pekpuglia/IC-Thrust-Vector-Control/README.md

# IC-Thrust-Vector-Control
Iniciação científica sobre vetoração de empuxo
