pekpuglia/IC-Thrust-Vector-Control/report/PreTextuais/listasimbolos.tex

\begin{longtable}{ll}
\(F\) & Empuxo propulsivo \\
\(\dot{m}\) & Vazão mássica \\
\(v_e\) & Velocidade de exaustão média \\
\(p_c\) & Pressão de câmara \\
\(p_e\) & Pressão de saída média \\
\(p_{amb}\) & Pressão ambiente \\
\(A_c\) & Área da seção transversal da câmara \\
\(A_e\) & Área da seção transversal da saída da tubeira \\
\(A_t\) & Área da seção transversal da garganta \\
\(\varepsilon \) & Razão de expansão \\
\(I_{\mathrm{sp}}\) & Impulso específico \\
\(C_F\) & Coeficiente de empuxo \\
\(C^*\) & Velocidade característica \\
\(F_x\) & Força horizontal, transversal ao motor foguete \\
\(F_y\) & Força vertical, na direção do empuxo propulsivo \\
\(M\) & Torque resultante \\
\(\delta \) & Deflexão da lâmina (\textit{jet vane}) \\
\(F_{x\delta}\) & Derivada da força lateral em relação à deflexão da lâmina \\
\(M_\delta \) & Derivada de momento em relação à deflexão da lâmina
\end{longtable}
