pekpuglia/IC-Thrust-Vector-Control/report/tese.tex

%%% Exemplo de utilização da classe ITA
%%%
%%%   por        Fábio Fagundes Silveira   -  ffs [at] ita [dot] br
%%%              Benedito C. O. Maciel     -  bcmaciel [at] ita [dot] br
%%%              Giovani Volnei Meinertz   -  giovani [at] ita [dot] br
%%%    	         Hudson Alberto Bode       -  bode [at] ita [dot]br
%%%    	         P. I. Braga de Queiroz    -  pi [at] ita [dot] br
%%%    	         Jorge A. B. Gripp         -  gripp [at] ita [dot] br
%%%    	         Juliano Monte-Mor         -  jamontemor [at] yahoo [dot] com [dot] br
%%%    	         Tarcisio A. B. Gripp      -  tarcisio.gripp [at] gmail [dot] com
%%%
%%%   Versão para overleaf:
%%%   por        Alejandro A. Rios Cruz    - aarc.88@gmail.com
%%%              Saulo Gómez               - sagomezs@unal.edu.co
%%%              Ocimar Santos             - ocimar.acad@gmail.com
%%%
%%%   Template disponibilizado em:
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
%   								dsc      		= Tese de Doutorado
%   								dscfem   		= Para Doutoras
%   								quali    		= Exame de Qualificacao
%   								qualifem 		= Exame de Qualificacao para Doutoras
% Para 'Draft Version'/'Versao Preliminar' com data no rodape, adicionar 'dv':
%   \documentclass[dsc, dv]{ita}
% Para trabalhos em Inglês, adicionar 'eng':
%   \documentclass[dsc, eng]{ita}
%		\documentclass[dsc, eng, dv]{ita}
%++++++++++++++++++++++++++++++++++++++++++++++++++++++++++++++++++++++++++++++
\documentclass[tg]{ita}    % ITA.cls based on standard book.cls
% Quando alterar a classe, por exemplo de [msc] para [msc, eng]) rode mais uma vez o botão BUILD OUTPUT caso haja erro
\usepackage[utf8]{inputenc}
\usepackage{ae}
\usepackage{graphicx}
\usepackage{epsfig}
\usepackage{amsmath}
\usepackage{amssymb}
\usepackage{subcaption}
\usepackage{multirow}
\usepackage{float}
\usepackage{amsthm}
\usepackage{url}         % formats URL addresses properly
\usepackage{appendix}    % allows appendix section to be included
\usepackage{lscape}      % allows a page to be rendered in landscape mode
\usepackage{multicol}    % allows text in multi columns
\usepackage{cancel}      % needed to show canceled terms in equations
\usepackage{lettrine}
\usepackage{float}
\usepackage{placeins}

%HHHHHHHHHHHHHHHHHHHHHHHHHHHHHHHHHHHHHHHHHHHHHHHHHHHHHHHHHHHHHHHHHHHHHHHHHHHHHHHHHHHHHHHHHHHHHHHHHHHHHHHHHHHH
%\usepackage{subfigure}
%\usepackage{subfigmat}
%PACOTEFIGURAS_SE _ERRADO_ESXCLUIR_ACIMA
\usepackage{booktabs}
%PACOTETABELAS_SE _ERRADO_ESXCLUIR_ACIMA
%HHHHHHHHHHHHHHHHHHHHHHHHHHHHHHHHHHHHHHHHHHHHHHHHHHHHHHHHHHHHHHHHHHHHHHHHHHHHHHHHHHHHHHHHHHHHHHHHHHHHHHHHHHHH

%++++++++++++++++++++++++++++++++++++++++++++++++++++++++++++++++++++++++++++++
% Espaçamento padrão de todo o documento
%++++++++++++++++++++++++++++++++++++++++++++++++++++++++++++++++++++++++++++++
\onehalfspacing

%singlespacing Para um espaçamento simples
%onehalfspacing Para um espaçamento de 1,5
%doublespacing Para um espaçamento duplo

%++++++++++++++++++++++++++++++++++++++++++++++++++++++++++++++++++++++++++++++
% Identificacoes (se o trabalho for em inglês, insira os dados em inglês)
% Para entradas abreviadas de Professora (Profa.) em português escreva: Prof$^\textnormal{a}$.
%++++++++++++++++++++++++++++++++++++++++++++++++++++++++++++++++++++++++++++++
\course{Engenheria Aeroespacial}  % Programa de PG ou Curso de Graduação
%\area{Aircraft Design} % Área de concentração na PG (Não utilizado no caso de TG)

% Autor do trabalho: Nome Sobrenome
\authorgender{masc}                     %sexo: masc ou fem
\author{Pedro Kuntz}{Puglia}
\itaauthoraddress{Rua H8C, Ap. 303}{12.228- 462}{São José dos Campos- SP}

% Titulo da Tese/Dissertação
\title{Caracterização de sistema de propulsão a gás frio com vetorização de empuxo}

% Orientador
\advisorgender{masc}                    % masc ou fem
\advisor{Prof.~Dr.}{Leonardo Gouvêa}{ITA}

% Coorientador (Caso não haja coorientador, colocar ambas as variáveis \coadvisorgender e \coadvisor comentadas, com um % na frente)
\coadvisorgender{masc}									% masc ou fem
\coadvisor{Prof.~Dr.}{Maurício Morales}{ITA}

% Pró-reitor da Pós-graduação
% \bossgender{masc}												% masc ou fem
% \boss{Prof.~Dr.}{John von Neumann}

%Coordenador do curso no caso de TG
\bosscoursegender{fem}									% masc ou fem
\bosscourse{Profa.~Dra.}{Cristiane Martins}

% Palavras-Chaves informadas pela Biblioteca -> utilizada na CIP
\kwcip{Propulsão}
\kwcip{Gás Frio}
\kwcip{Vetorização de empuxo}

% membros da banca examinadora

% \examiner{Prof. Dr.}{Alan Turing}{Presidente}{ITA}
% \examiner{Prof. Dr.}{Linus Torwald}{}{UXXX}
% \examiner{Prof. Dr.}{Richard Stallman}{}{UYYY}
% \examiner{Prof. Dr.}{Donald Duck}{}{DYSNEY}
% \examiner{Prof. Dr.}{Mickey Mouse}{}{DISNEY}

% Data da defesa (mês em maiúsculo, se trabalho em inglês, e minúsculo se trabalho em português)
\date{11}{julho}{2023}

% Número CDU - (somente para TG)
\cdu{???.??}

% Glossario
\makeglossary
\frontmatter

\begin{document}
\input{PreTextuais/main}

\mainmatter

%todo
%resumo, abstract

% Os capitulos comecam aqui
\chapter{\textbf{INTRODUÇÃO}}
\input{text/intro.tex}

\chapter{\textbf{METODOLOGIA}}
\input{text/metodologia.tex}

\chapter{\textbf{RESULTADOS E DISCUSSÃO}}
\input{text/resultados.tex}

\chapter{\textbf{CONCLUSÃO}}
\input{text/conclusao.tex}
% REFERENCIAS BIBLIOGRAFICAS
\renewcommand\bibname{\itareferencesnamebabel} %renomear título do capítulo referências
\bibliography{Referencias/referencias}

% Apendices
\appendix
\chapter{Histórico de desenvolvimento do motor foguete}\label{sec:app}
\input{text/apendice.tex}

% Anexos
\annex

% Glossario
%\itaglossary
%\printglossary

% Folha de Registro do Documento
% Valores dos campos do formulario
\FRDitadata{25 de março de 2015}
\FRDitadocnro{DCTA/ITA/DM-018/2015} %(o número de registro você solicita a biblioteca)
\FRDitaorgaointerno{Instituto Tecnológico de Aeronáutica -- ITA}
%Exemplo no caso de pós-graduação: Instituto Tecnol{\'o}gico de Aeron{\'a}utica -- ITA
\FRDitapalavrasautor{Cupim; Cimento; Estruturas}
\FRDitapalavrasresult{Propulsão; Gás Frio; Vetorização de empuxo;}
%Exemplo no caso de graduação (TG):
%\FRDitapalavraapresentacao{Trabalho de Graduação, ITA, São José dos Campos, 2015. \NumPenultimaPagina\ páginas.}
%Exemplo no caso de pós-graduação (msc, dsc):
\FRDitapalavraapresentacao{ITA, São José dos Campos. Curso de Mestrado. Programa de Pós-Graduação em Engenharia Aeronáutica e Mecânica. Área de Sistemas Aeroespaciais e Mecatrônica. Orientador: Prof.~Dr. Adalberto Santos Dupont. Coorientadora: Prof$^\textnormal{a}$.~Dr$^\textnormal{a}$. Doralice Serra. Defesa em 05/03/2015. Publicada em 25/03/2015.}
\FRDitaresumo{\input{PreTextuais/resumo}}
%  Primeiro Parametro: Nacional ou Internacional -- N/I
%  Segundo parametro: Ostensivo, Reservado, Confidencial ou Secreto -- O/R/C/S
\FRDitaOpcoes{N}{O}
% Cria o formulario
\itaFRD

\end{document}
% Fim do Documento. O massacre acabou!!! :-)
