pekpuglia/IC-Thrust-Vector-Control/report/text/conclusao.tex

A proposta deste trabalho, de desenvolver um sistema de vetorização de empuxo e caracterizar seu desempenho, foi executada. Desenvolveu-se um motor foguete de gás frio de \(2\;\mathrm{N} \) que foi validado experimentalmente e então usado em um sistema de vetorização de empuxo com lâmina defletora (\textit{jet vane}). Por fim, este sistema foi caracterizado em relação à perda de empuxo causada pela adição da lâmina defletora e suas derivadas de controle foram obtidas. Apesar do objetivo ter sido atingido, foram encontradas várias dificuldades e fontes de erros experimentais que devem ser abordadas em trabalhos futuros.
