pekpuglia/IC-Thrust-Vector-Control/nozzle_design/scripts/thust_analysis.png

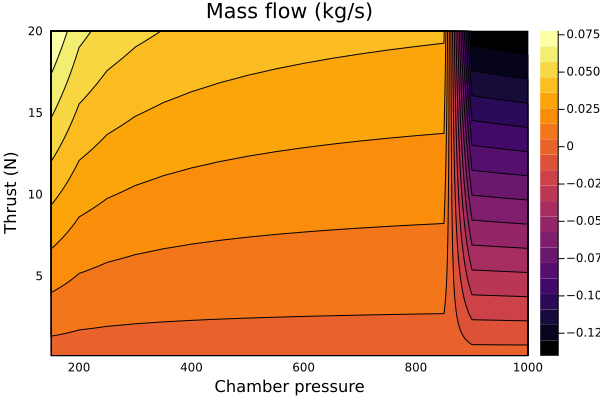
nozzle_design/scripts/thust_analysis.png
