pekpuglia/IC-Thrust-Vector-Control/report/img/balanca.png

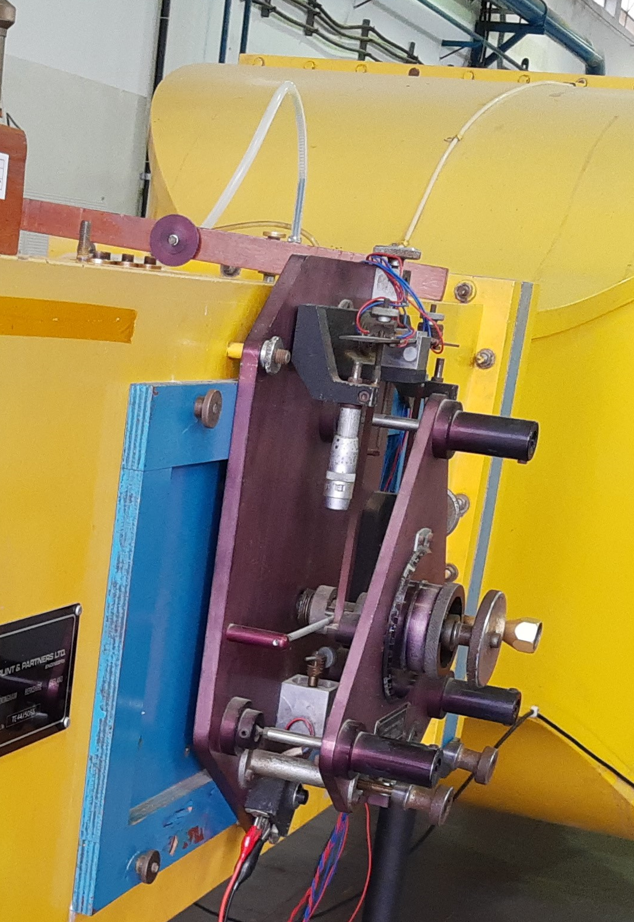
report/img/balanca.png
