pekpuglia/IC-Thrust-Vector-Control/report/img/massas.png

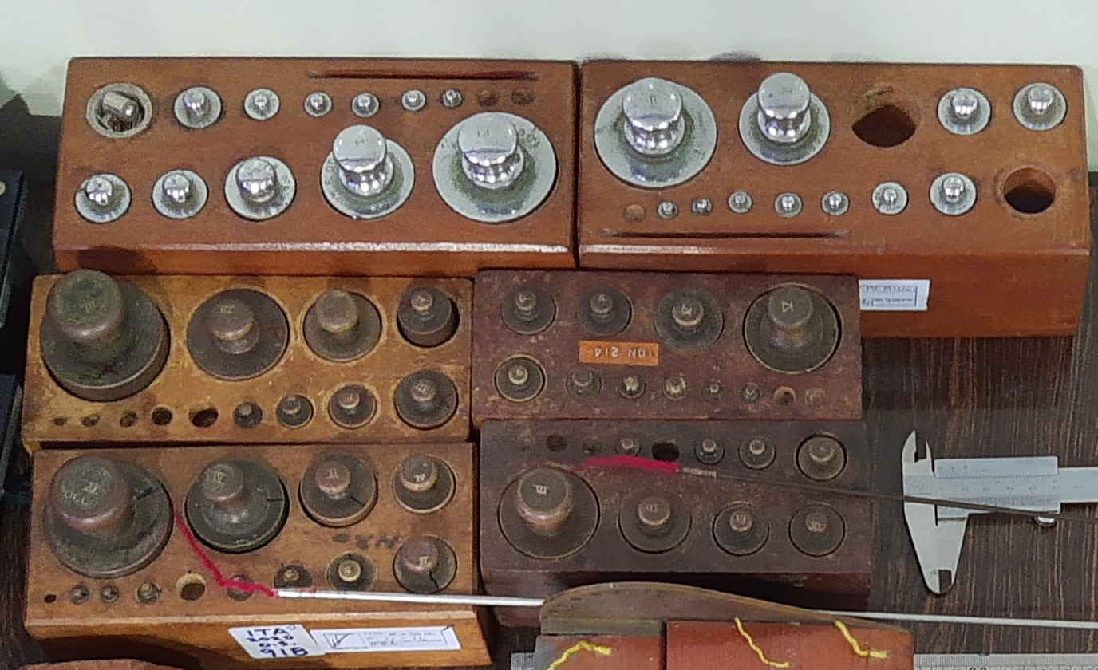
report/img/massas.png
