pekpuglia/IC-Thrust-Vector-Control/CAD/Arco.stl

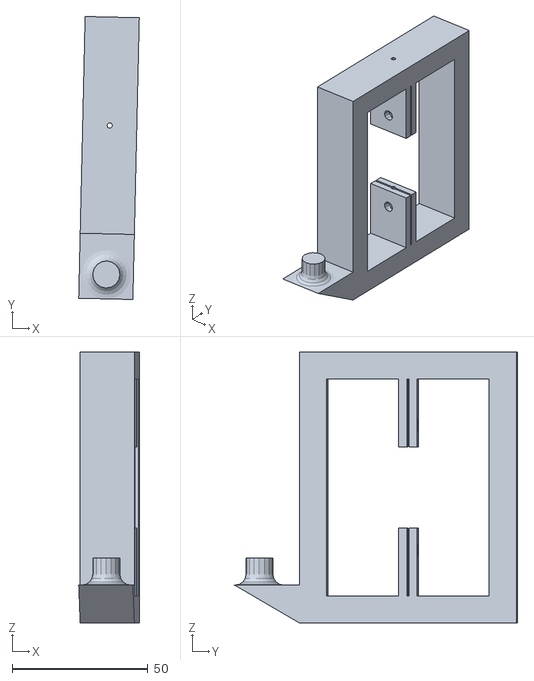
[picture p39: CAD file, 2023-04-16]
CAD/Arco.stl
22.4 x 104.4 x 100.0
