pekpuglia/IC-Thrust-Vector-Control/CAD/iter_1/Mancal.stl

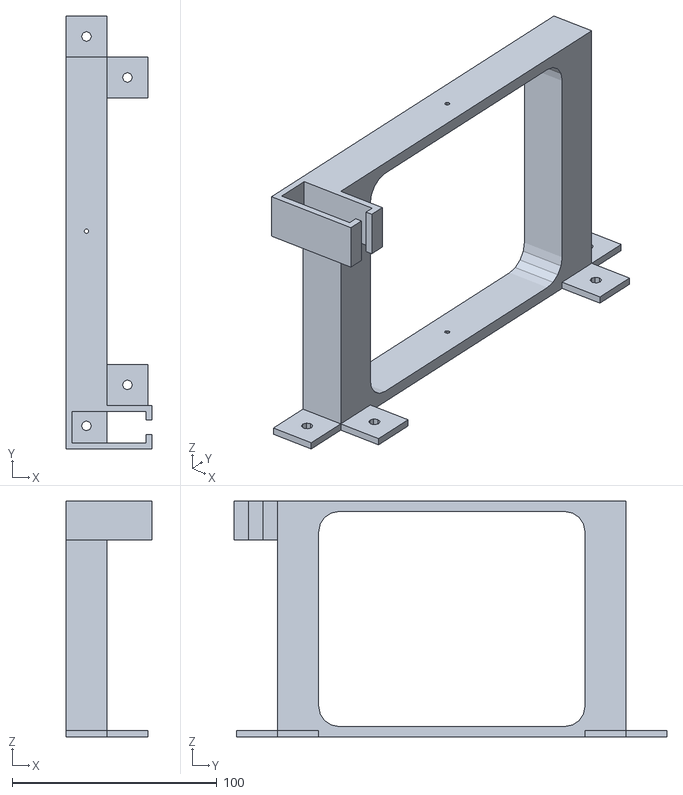
[picture p40: CAD file, 2023-03-10]
CAD/iter_1/Mancal.stl
42.0 x 211.3 x 115.0
