pekpuglia/IC-Thrust-Vector-Control/CAD/iter_2/suporte_motor.stl

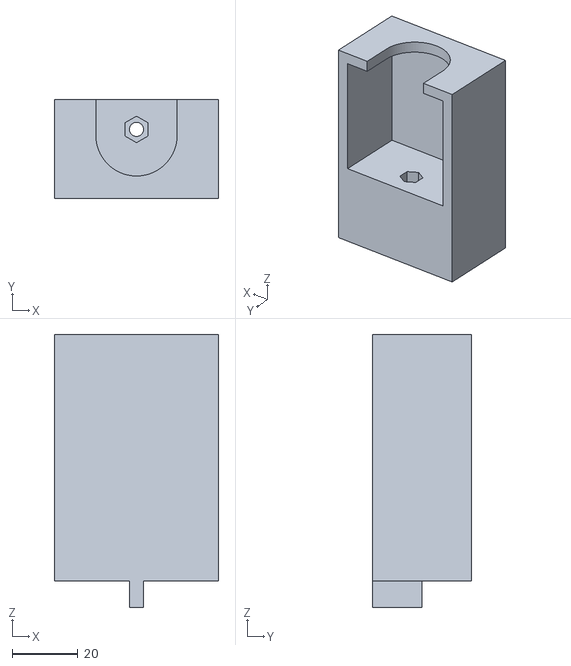
[picture p41: CAD file, 2023-03-22]
CAD/iter_2/suporte_motor.stl
50.0 x 30.0 x 83.0
