pekpuglia/IC-Thrust-Vector-Control/nozzle_design/geometry/iter2/probed.stl

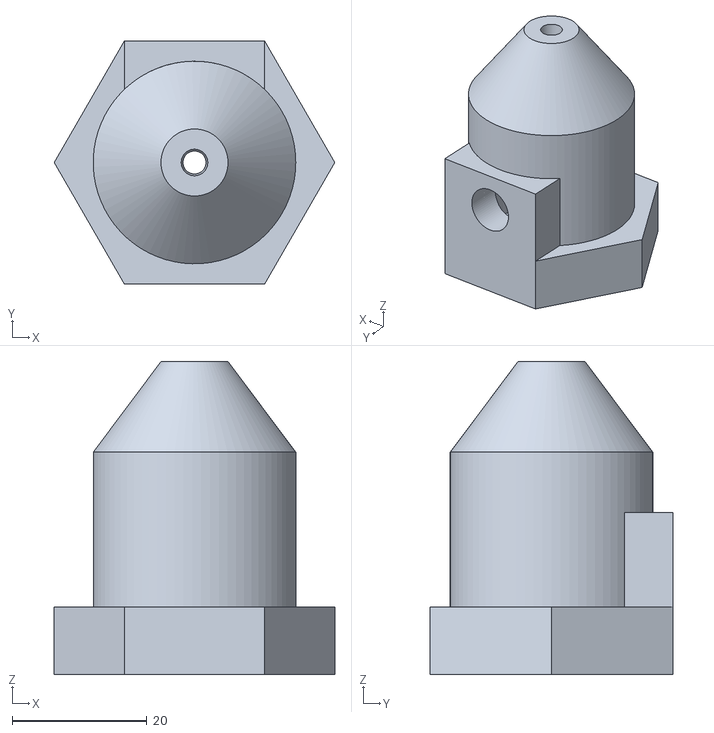
[picture p42: CAD file, 2022-08-22]
nozzle_design/geometry/iter2/probed.stl
41.6 x 36.1 x 46.4
