pekpuglia/IC-Thrust-Vector-Control/nozzle_design/geometry/iter3/air_motor.stl

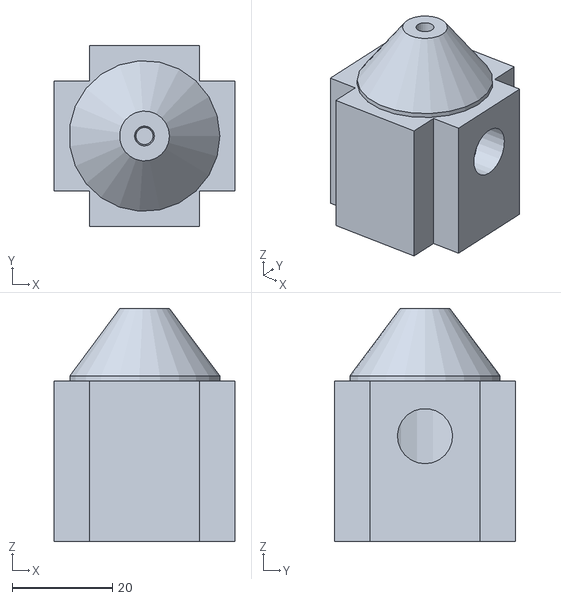
[picture p43: CAD file, 2022-10-24]
nozzle_design/geometry/iter3/air_motor.stl
36.1 x 36.1 x 46.4
