pekpuglia/IC-Thrust-Vector-Control/nozzle_design/geometry/iter4_fix_thrust/corrected_nozzle_0.2 mm.stl

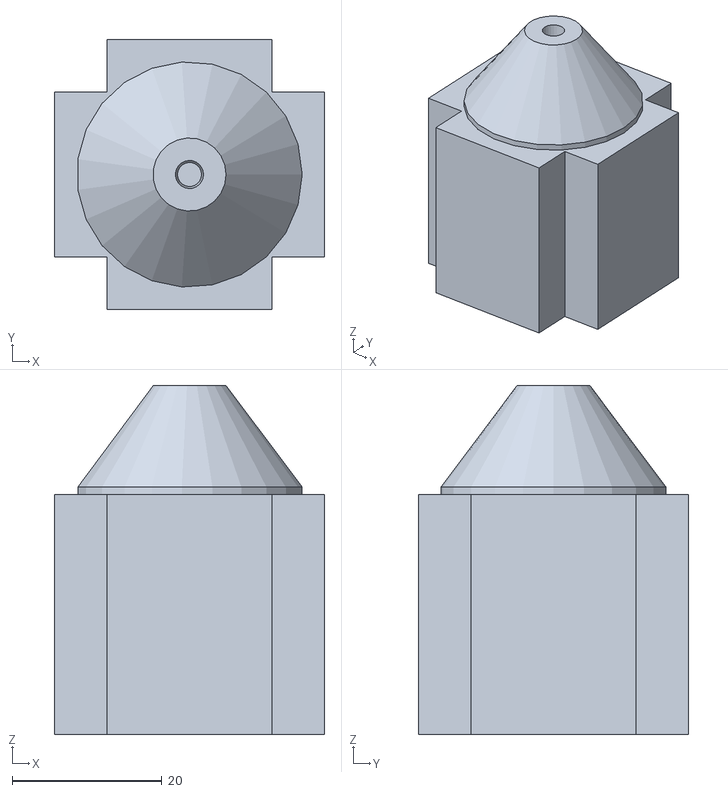
[picture p44: CAD file, 2023-03-06]
nozzle_design/geometry/iter4_fix_thrust/corrected_nozzle_0.2 mm.stl
36.1 x 36.1 x 46.5
