pekpuglia/IC-Thrust-Vector-Control/nozzle_design/geometry/iter5/nozzle_2N_elongated.stl

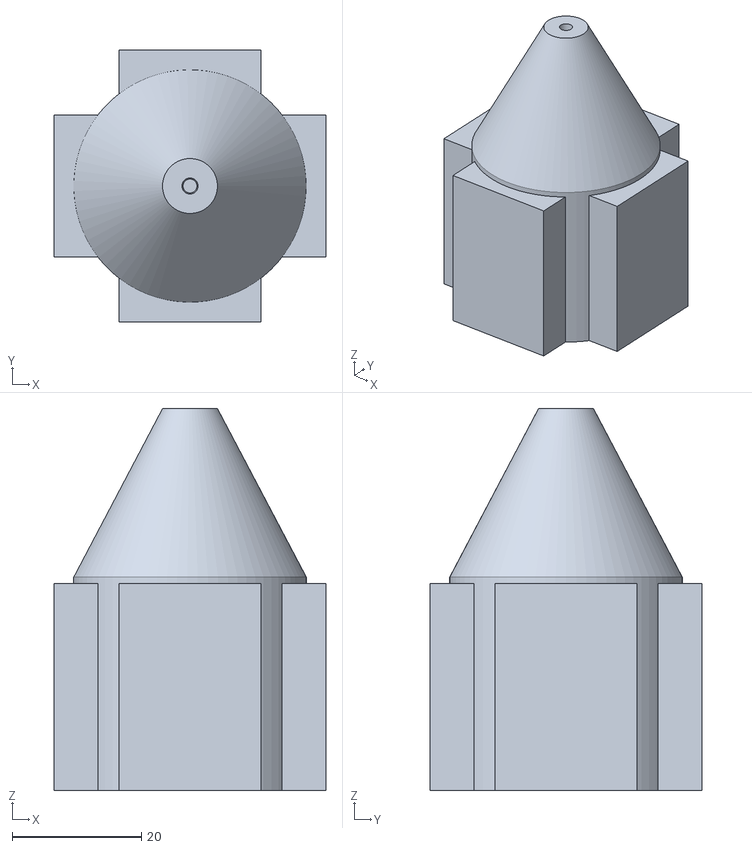
[picture p45: CAD file, 2023-06-27]
nozzle_design/geometry/iter5/nozzle_2N_elongated.stl
42.0 x 42.0 x 59.1
