pekpuglia/IC-Thrust-Vector-Control/nozzle_design/geometry/test_16_08_2022/connected.stl

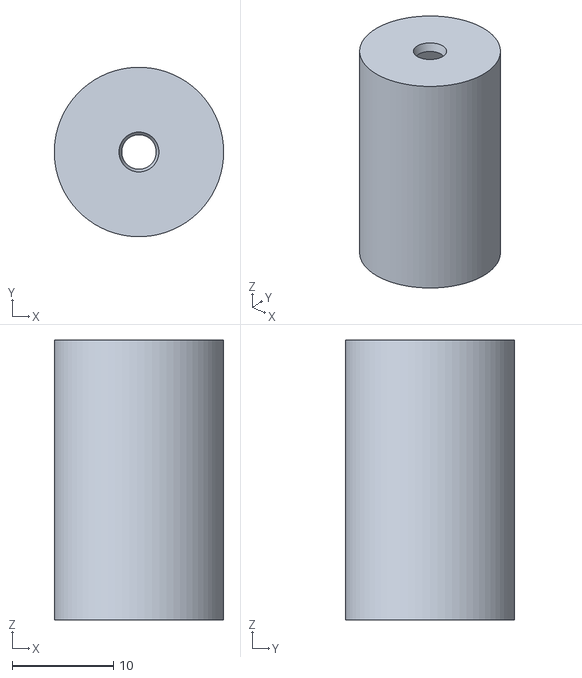
[picture p46: CAD file, 2022-08-15]
nozzle_design/geometry/test_16_08_2022/connected.stl
16.8 x 16.8 x 27.7
