pekpuglia/IC-Thrust-Vector-Control/CAD/iter_1/Arco.stl

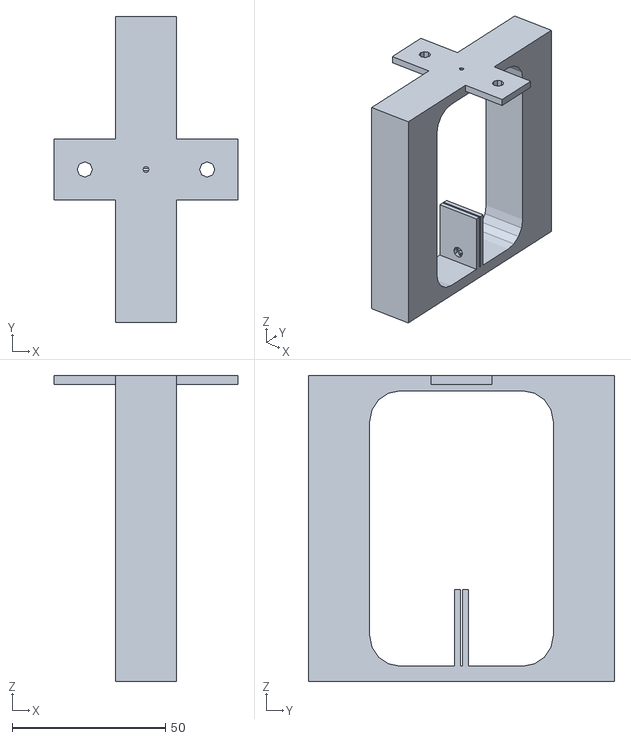
[picture p47: CAD file, 2023-03-10]
CAD/iter_1/Arco.stl
60.0 x 100.0 x 100.0
