pekpuglia/IC-Thrust-Vector-Control/CAD/iter_2/motor_hub.stl

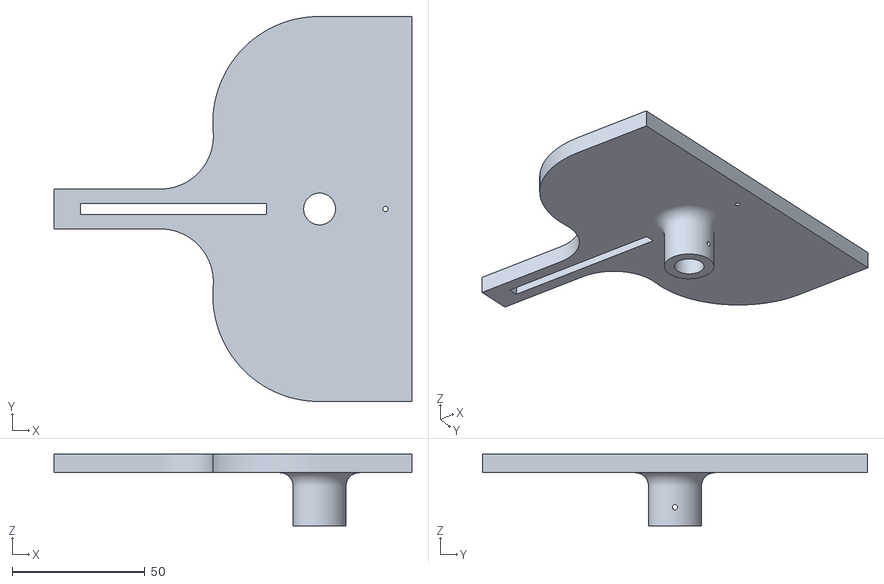
[picture p48: CAD file, 2023-03-22]
CAD/iter_2/motor_hub.stl
134.8 x 145.0 x 27.0
