pekpuglia/IC-Thrust-Vector-Control/CAD/ServoExtender.stl

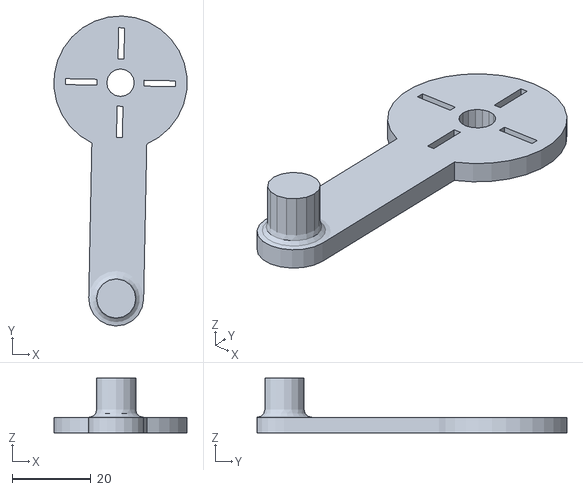
[picture p49: CAD file, 2023-04-16]
CAD/ServoExtender.stl
33.9 x 79.0 x 14.0
