pekpuglia/IC-Thrust-Vector-Control/nozzle_design/geometry/iter2/connected.stl

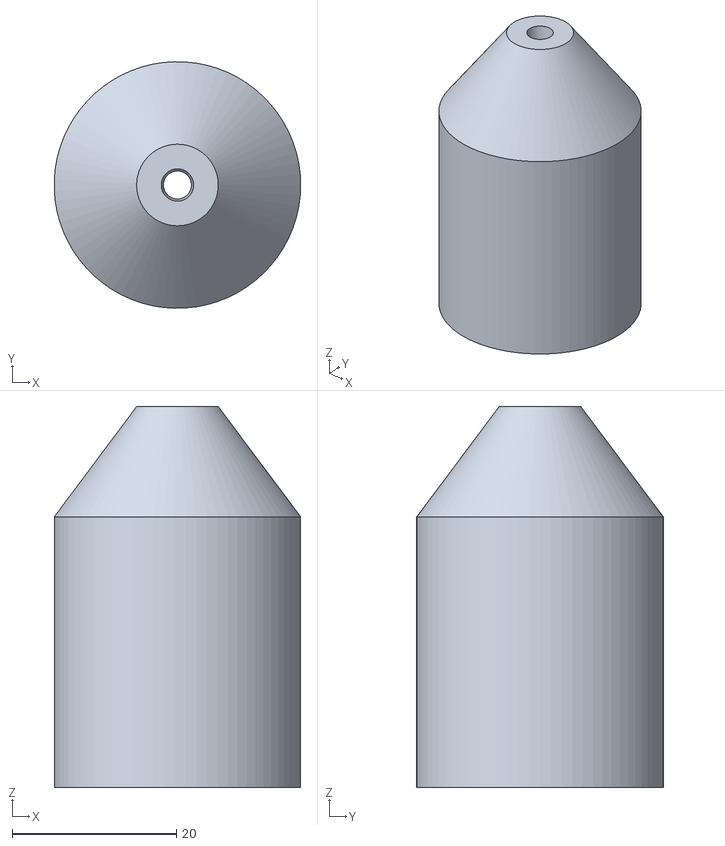
[picture p50: CAD file, 2022-08-22]
nozzle_design/geometry/iter2/connected.stl
30.0 x 30.1 x 46.4
