pekpuglia/IC-Thrust-Vector-Control/nozzle_design/geometry/iter3/support.stl

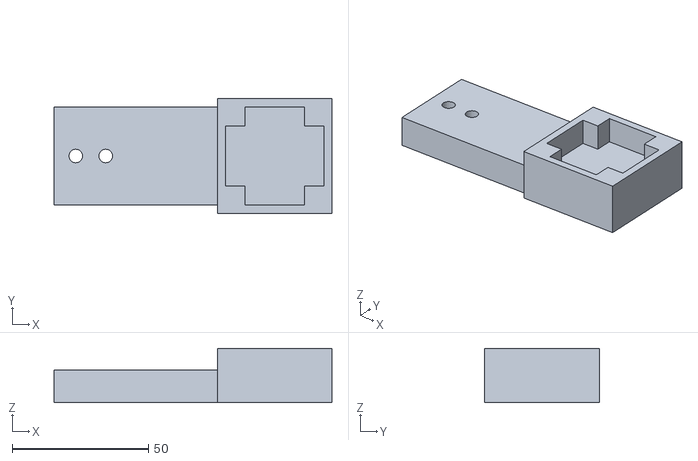
[picture p51: CAD file, 2022-09-19]
nozzle_design/geometry/iter3/support.stl
102.1 x 42.1 x 20.0
