pekpuglia/IC-Thrust-Vector-Control/nozzle_design/geometry/iter4_fix_thrust/corrected_nozzle_0.0 mm.stl

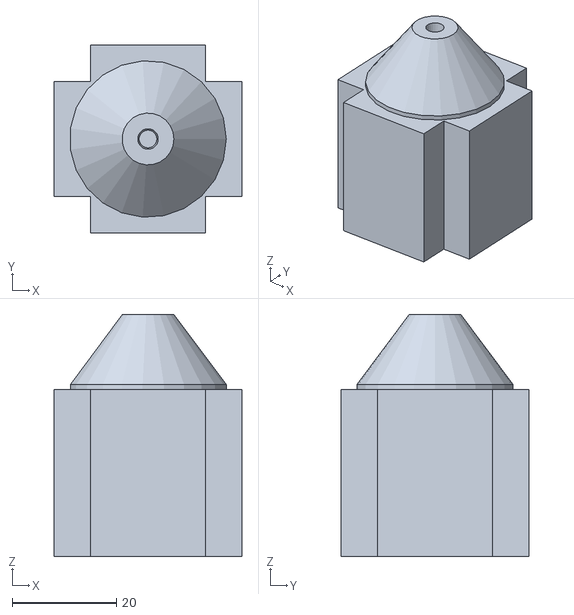
[picture p52: CAD file, 2023-03-06]
nozzle_design/geometry/iter4_fix_thrust/corrected_nozzle_0.0 mm.stl
36.1 x 36.1 x 46.4
