pekpuglia/IC-Thrust-Vector-Control/CAD/iter_1/Tensionador.stl

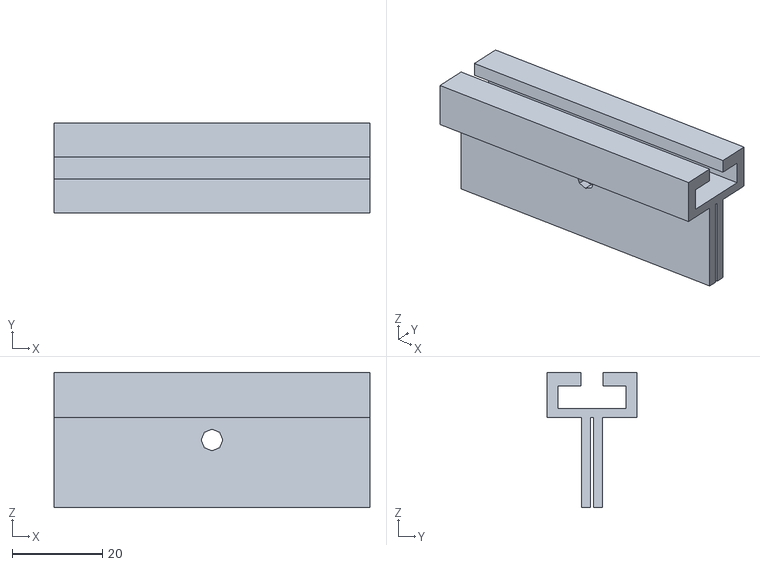
[picture p53: CAD file, 2023-03-10]
CAD/iter_1/Tensionador.stl
70.0 x 20.0 x 30.0
