pekpuglia/IC-Thrust-Vector-Control/CAD/Linkagem.stl

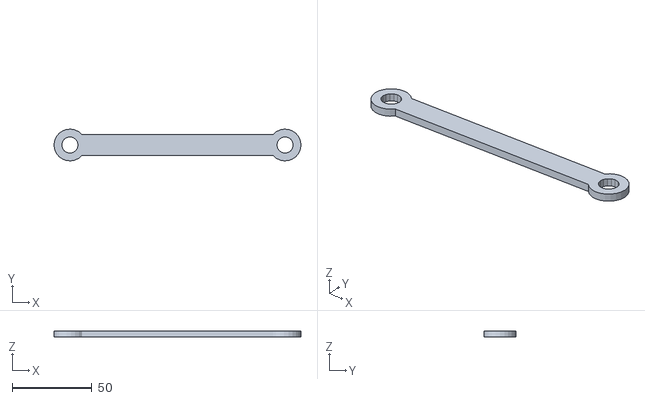
[picture p54: CAD file, 2023-04-16]
CAD/Linkagem.stl
155.0 x 20.0 x 4.00
