pekpuglia/IC-Thrust-Vector-Control/nozzle_design/geometry/iter3/padded_side_holes.stl

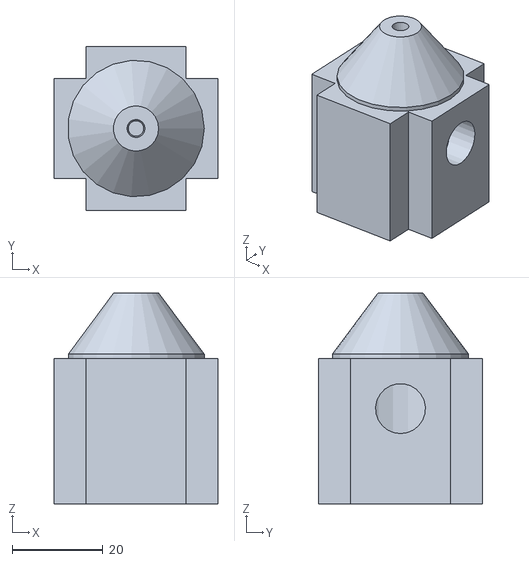
[picture p55: CAD file, 2022-09-19]
nozzle_design/geometry/iter3/padded_side_holes.stl
36.1 x 36.1 x 46.4
