pekpuglia/IC-Thrust-Vector-Control/nozzle_design/geometry/iter5/nozzle_2N.stl

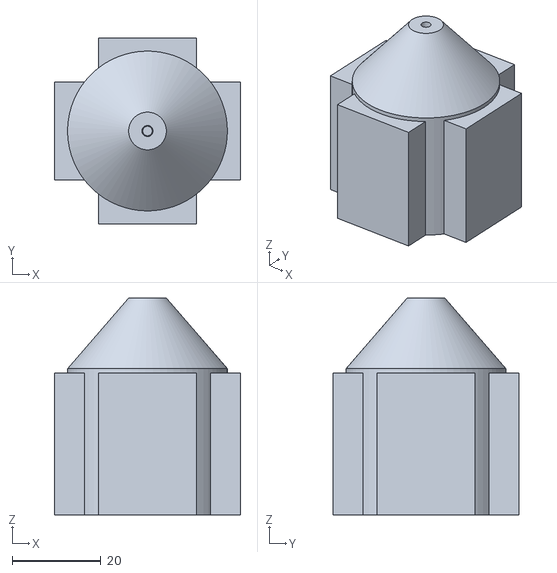
[picture p56: CAD file, 2023-03-21]
nozzle_design/geometry/iter5/nozzle_2N.stl
42.0 x 42.0 x 48.9
