pekpuglia/IC-Thrust-Vector-Control/CAD/motor_hub.stl

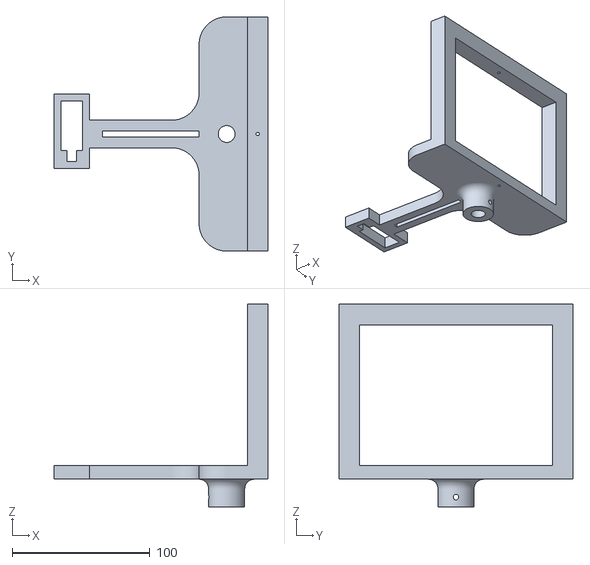
[picture p57: CAD file, 2023-03-31]
CAD/motor_hub.stl
155.3 x 170.0 x 147.0
