pekpuglia/IC-Thrust-Vector-Control/nozzle_design/geometry/iter5/support.stl

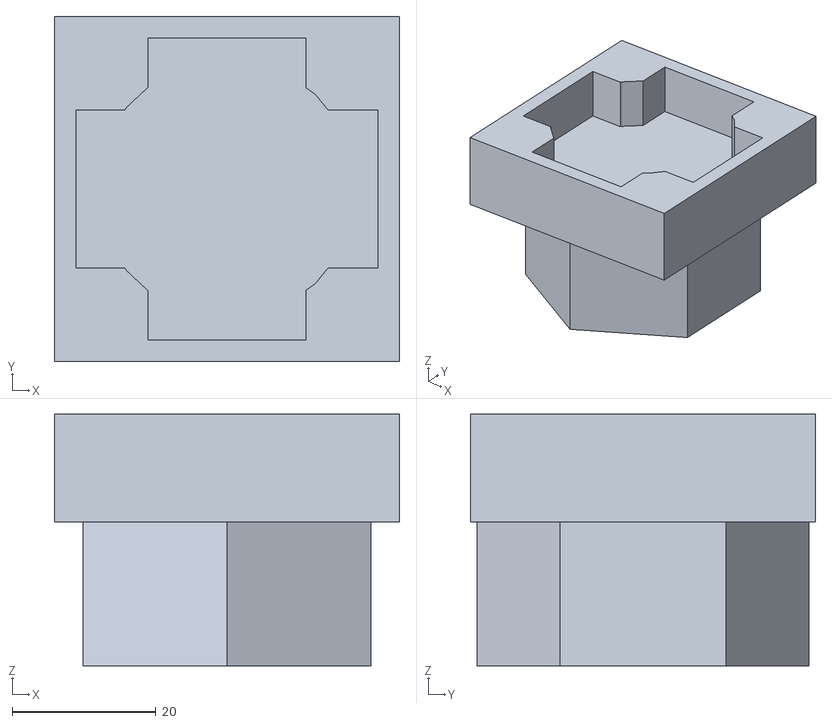
[picture p58: CAD file, 2023-03-21]
nozzle_design/geometry/iter5/support.stl
48.0 x 48.0 x 35.0
