pekpuglia/IC-Thrust-Vector-Control/(list of files, cad)

Other CAD files:
nozzle_design/geometry/iter5/nozzle_2N_probed.stl
nozzle_design/geometry/iter2/hexagon.stl
nozzle_design/geometry/iter4_fix_thrust/corrected_nozzle_0.1 mm.stl
nozzle_design/geometry/iter4_fix_thrust/corrected_nozzle_0.4 mm.stl
nozzle_design/geometry/iter4_fix_thrust/corrected_nozzle_0.3 mm.stl
nozzle_design/geometry/iter4_fix_thrust/airmotor.stl
CAD/Arco.CATPart
CAD/Linkagem.CATPart
CAD/Parafuso M4.CATPart
CAD/Porca M4.CATPart
CAD/Servo.CATProduct
CAD/ServoArm.CATPart
CAD/ServoBase.CATPart
CAD/ServoExtender.CATPart
CAD/SuporteMotor.CATPart
CAD/Tensionador.CATPart
CAD/iter_1/Arco.CATPart
CAD/iter_1/Defletor.CATProduct
CAD/iter_1/Mancal.CATPart
CAD/iter_1/Tensionador.CATPart
CAD/iter_2/SuporteMotor.CATPart
CAD/iter_2/assembly_amarelinho.CATProduct
CAD/iter_2/motor_hub.CATPart
CAD/montagem_amarelinho.CATProduct
CAD/motor_hub.CATPart
nozzle_design/geometry/iter3/load_cell_support.CATPart
