pekpuglia/IC-Thrust-Vector-Control/report/img/tvc_assembly_back.jpeg

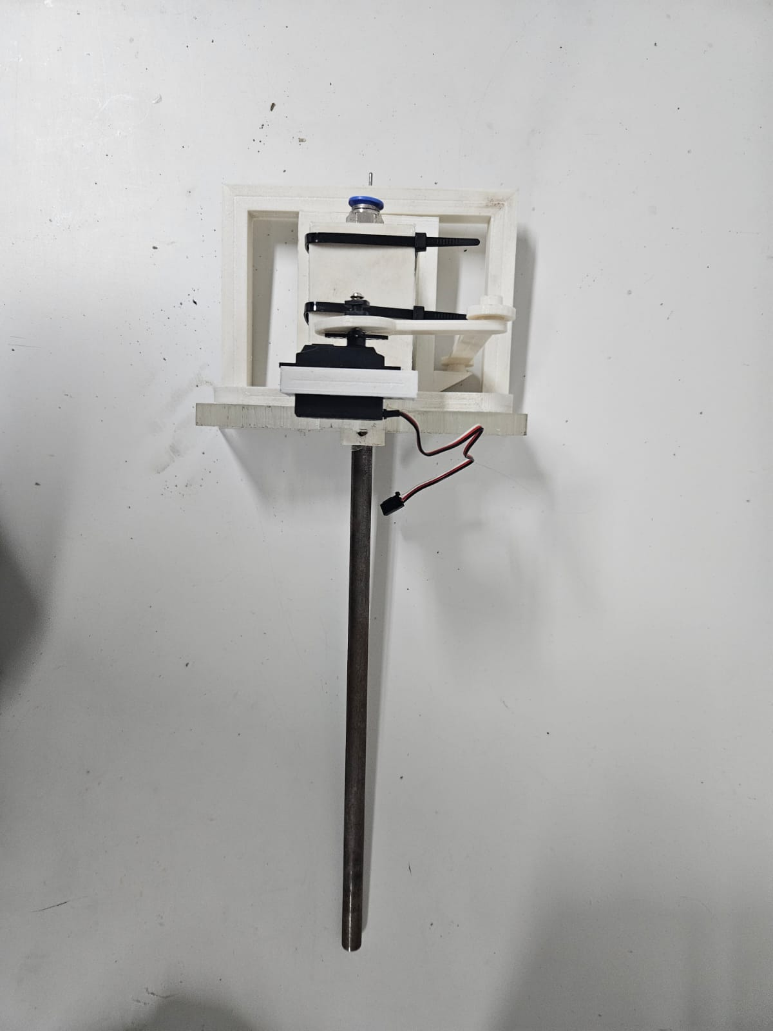
report/img/tvc_assembly_back.jpeg
