pekpuglia/IC-Thrust-Vector-Control/report/img/tvc_assembly_front.jpeg

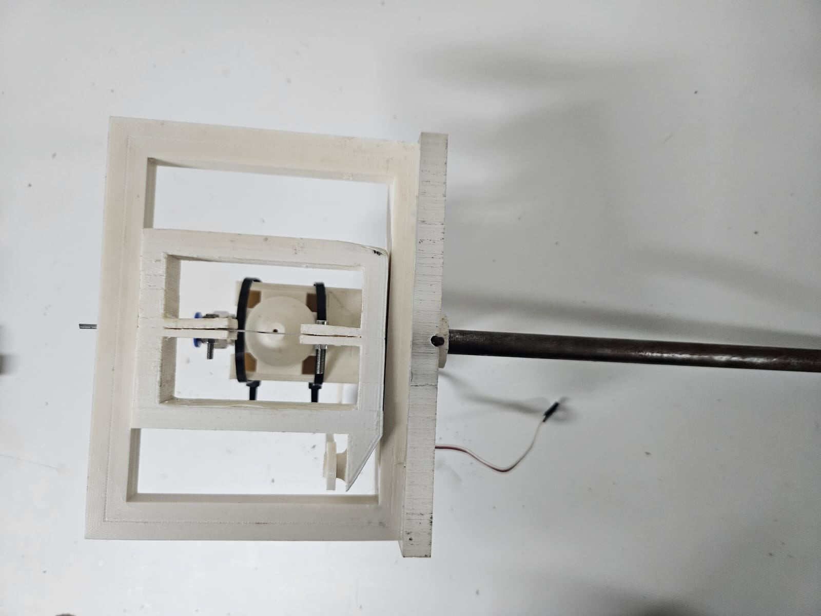
report/img/tvc_assembly_front.jpeg
