pekpuglia/IC-Thrust-Vector-Control/report/img/tvc_assembly_right.jpeg

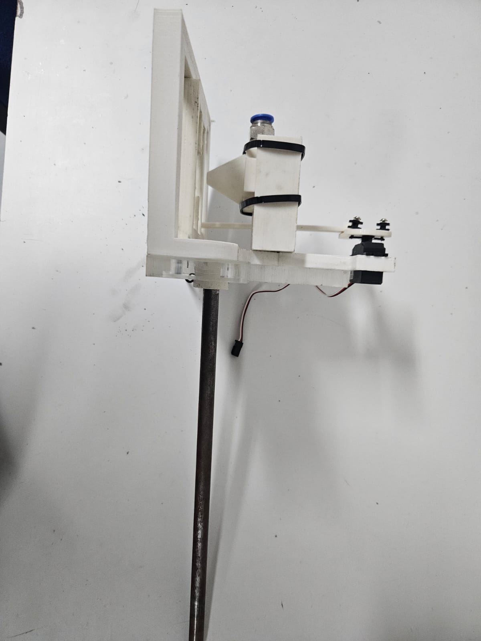
report/img/tvc_assembly_right.jpeg
