pekpuglia/IC-Thrust-Vector-Control/3dof_test/output/rotated_exp7_5bar_70_a_110.png

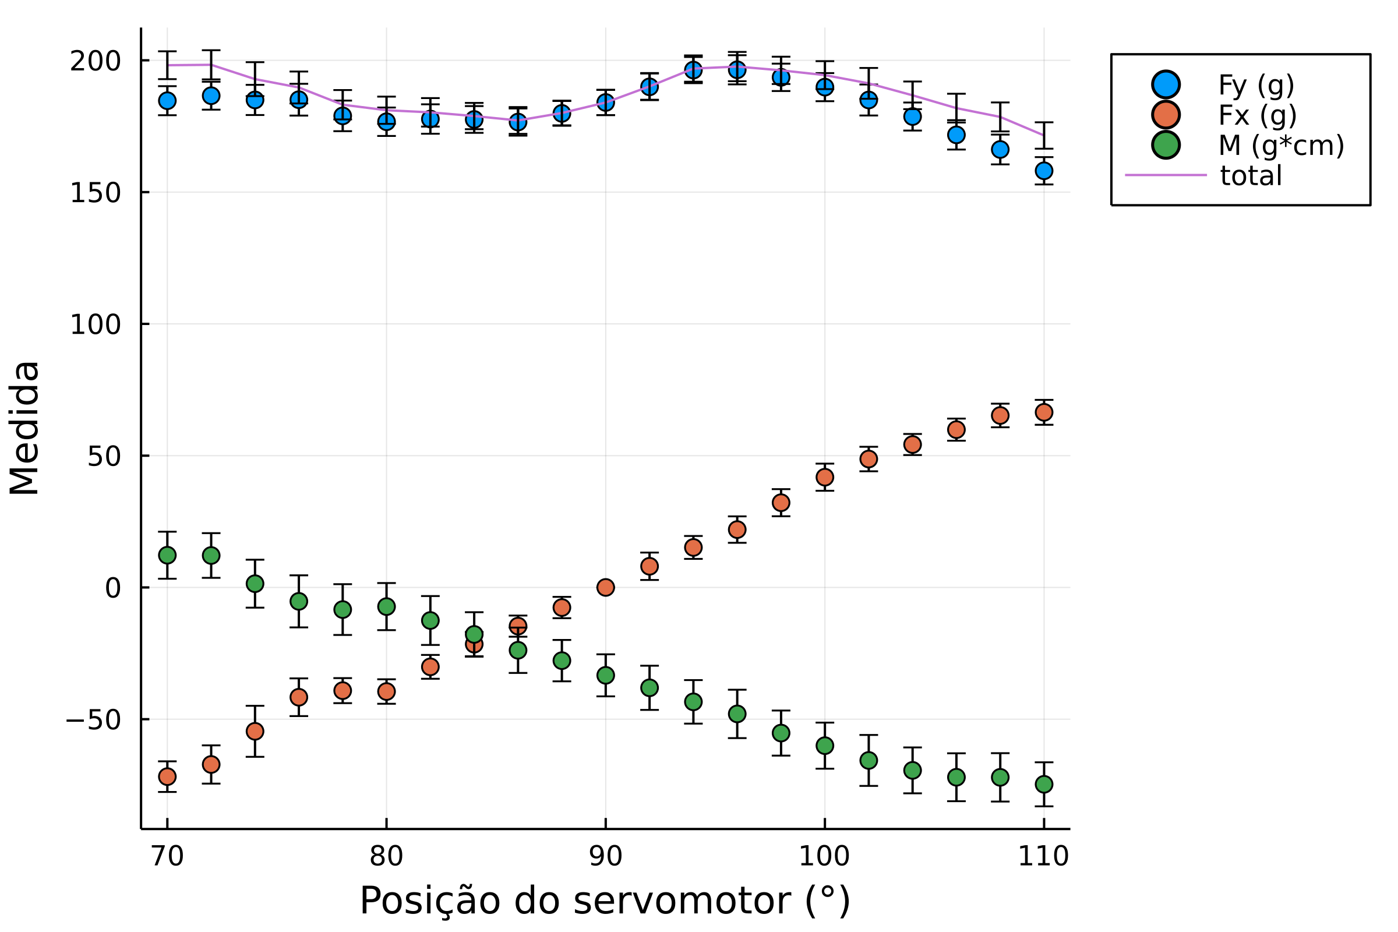
3dof_test/output/rotated_exp7_5bar_70_a_110.png
