pekpuglia/IC-Thrust-Vector-Control/3dof_test/output/rotated_exp12_5bar_110_a_70.png

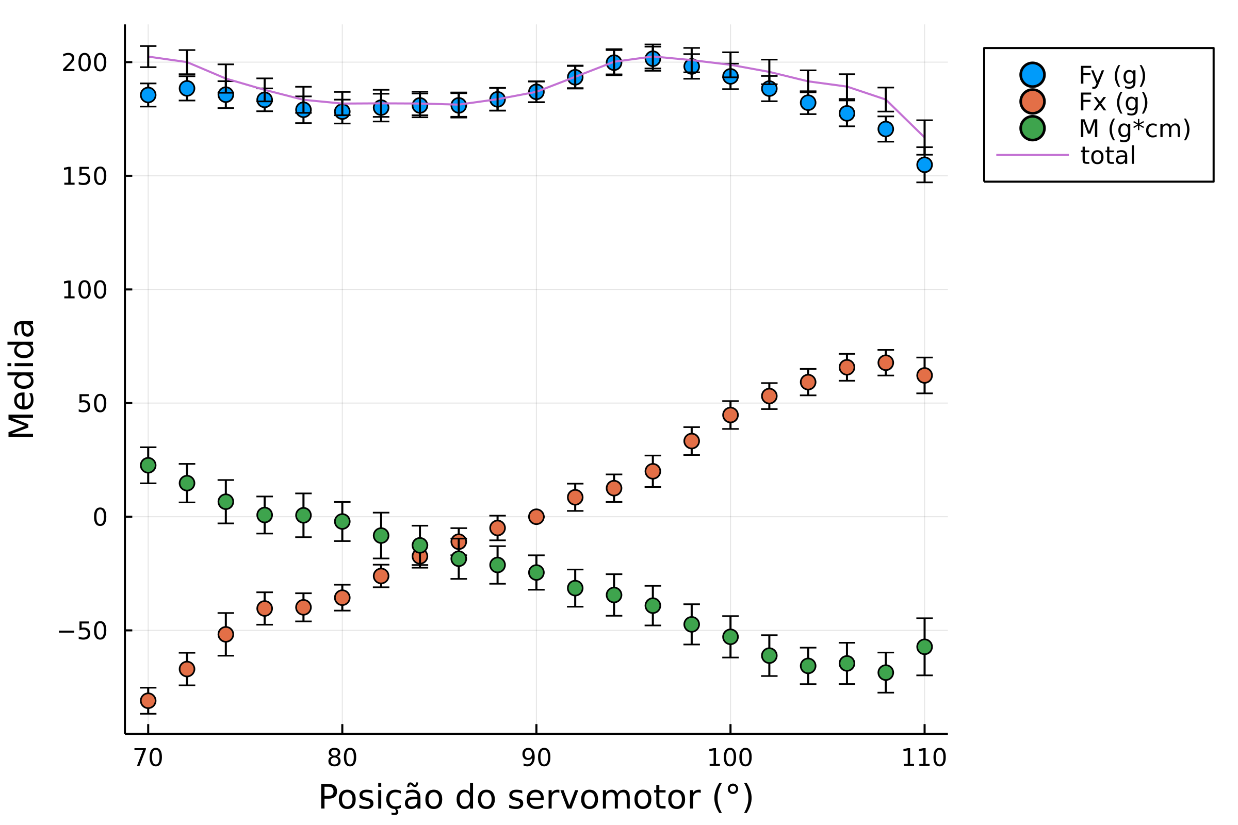
3dof_test/output/rotated_exp12_5bar_110_a_70.png
