pekpuglia/IC-Thrust-Vector-Control/1dof_test/thrust_stand.ino

#include "TestStand.hpp"

/*
    TODO:
    - CLIComponent - interface p cada componente na CLI
    - CLI a própria
        * tara da balança - sem inputs extras
        * ajuste da pressão - dar pressão alvo ou só exibir pressão atual?
        * executar teste - input do tempo de medição, envolve vários componentes
*/

void setup() {
    Serial.begin(9600);
}

TestStand teststand(LoadCell(MegaPins::D3, MegaPins::D4),
            Thermocouple(MegaPins::D6, MegaPins::D8, MegaPins::D11),
            PressureTransducer(A5),
            NOValve(MegaPins::D5));

OutPin led(LED_BUILTIN);

void loop() {
    if (Serial.available() > 0) {
        led.digitalWrite(true);
        delay(50);
        led.digitalWrite(false);
        CommandData command = CommandData::receiveData();
        teststand.executeCommand(command);
    }
    // float x = 1.56 + rand();
    // Serial.println(x);
    // delay(100);
}
