pekpuglia/IC-Thrust-Vector-Control/1dof_test/PressureTransducer.hpp

#ifndef PRESSURE_TRANSDUCER_HPP
#define PRESSURE_TRANSDUCER_HPP

#include "Arduino.h"

class PressureTransducer
{
private:
    const uint8_t analogSignalPin;
public:
    PressureTransducer(uint8_t analogSignalPin);
    float readBar();
};

#endif
