pekpuglia/IC-Thrust-Vector-Control/(commit log)

2022-08-03 adicionadas packages de Julia
2022-08-03 módulos de projeto da propulsão
2022-08-09 new propellant interface changes
2022-08-10 fluxograma de projeto
2022-08-10 correções de exibição
2022-08-10 better nozzle conditions
2022-08-10 draft of nozzle design
2022-08-10 mdot vs thrust and chamber pressure
2022-08-10 thrust analysis
2022-08-12 nozzle analysis script
2022-08-12 export flow wall
2022-08-12 connector and stagnator
2022-08-12 base and connector
2022-08-15 changed absolute tolerances in stl export
2022-08-15 stagnated chamber design
2022-08-16 first stl tested
    [connected.stl, stagnator.stl]
2022-08-18 enlarged hexagon
    [connected.stl, hexagon.stl]
2022-08-22 refactor nozzle features
2022-08-22 most recent STLs
    [connected.stl, hexagon.stl, probed.stl]
2022-08-24 SIde hole
2022-08-31 corrected flow wall error
2022-08-31 padded nozzle + support
    [padded_side_holes.stl, support.stl]
2022-08-31 padded nozzle dev
2022-09-06 thermo couple code
2022-09-11 fixed compilation error by adding Arduino header
    [Thermocouple.hpp]
2022-09-19 updated motor design
    [padded_side_holes.stl]
2022-09-19 updated support to fit new load cell
    [support.stl]
2022-09-19 nozzle support CAD
2022-10-12 valve working
2022-10-18 pressure transducer base code
2022-10-24 converted motor to air
    [air_motor.stl]
2022-10-28 implementação do menu
    [load_cell_support.CATPart]
2023-02-28 cad do defletor
    [Arco.CATPart, Defletor.CATProduct, Mancal.CATPart, Parafuso M4.CATPart, Porca M4.CATPart, Servo.CATProduct, ServoArm.CATPart, ServoBase.CATPart]
2023-03-06 corrected bad stl generation
2023-03-06 corrected nozzles
    [airmotor.stl, corrected_nozzle_0.0 mm.stl, corrected_nozzle_0.1 mm.stl, corrected_nozzle_0.2 mm.stl, corrected_nozzle_0.3 mm.stl, corrected_nozzle_0.4 mm.stl]
2023-03-09 2N motors
    [nozzle_2N.stl, nozzle_2N_probed.stl]
2023-03-10 correct dimensions
    [Arco.CATPart, Defletor.CATProduct, Mancal.CATPart, Servo.CATProduct, ServoBase.CATPart, Tensionador.CATPart]
2023-03-10 last mod
    [Arco.CATPart]
2023-03-21 added support for the new nozzle
    [nozzle_2N.stl, support.stl]
2023-03-22 elongated motor
    [nozzle_2N_elongated.stl]
2023-03-22 refactored cad directory
    [Arco.CATPart, Arco.stl, Defletor.CATProduct, Mancal.CATPart, Mancal.stl, Tensionador.CATPart, Tensionador.stl]
2023-03-22 amarelinho hub
    [SuporteMotor.CATPart, assembly_amarelinho.CATProduct, motor_hub.CATPart, motor_hub.stl, suporte_motor.stl]
2023-03-31 third iteration of the motor hub
    [Arco.CATPart, Arco.stl, Linkagem.CATPart, Linkagem.stl, Servo.CATProduct, ServoArm.CATPart, ServoBase.CATPart, ServoExtender.CATPart]
2023-04-16 updated cad for final design
    [Arco.CATPart, Arco.stl, Linkagem.CATPart, Linkagem.stl, ServoExtender.CATPart, ServoExtender.stl, montagem_amarelinho.CATProduct, motor_hub.CATPart]
2023-05-08 servidor do arduino p/ teste no feng
2023-05-08 reconfigured arduino settings
2023-06-02 correct calibration?
2023-06-03 calibration is correct!
2023-06-27 intro teórica começada
    [nozzle_2N_elongated.stl, nozzle_2N_probed.stl]
2023-07-09 coefs propulsivos e figuras de resultados
2023-07-09 validação do motor
2023-07-10 assembly render
    [Arco.CATPart, Linkagem.CATPart, ServoArm.CATPart, ServoBase.CATPart, ServoExtender.CATPart, SuporteMotor.CATPart, montagem_amarelinho.CATProduct, motor_hub.CATPart]
2023-07-10 tvc assembly pics
2023-07-12 pretty calibration plots
2023-07-12 novos gráficos de resultados
2023-07-12 metodologia de calib ajustada
2023-07-12 calibration results
2023-07-12 calibration error fixed
2023-07-13 true chamber pressure calculus
2023-07-13 cálculo de valores médios
2023-07-13 foto motor
2023-07-13 lista de simbolos
2023-07-14 derivadas de controle
2023-07-15 figura da bancada de teste de empuxo
